gnihi/thundercloud/img/IMG_20180104_174955.jpg

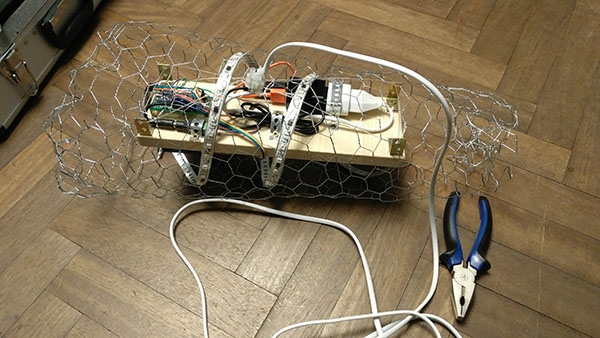
img/IMG_20180104_174955.jpg
