gnihi/thundercloud/(commit log)

2018-01-07 Refactor current state
2018-01-09 Fix bug - max average has to be a double
    [thundercloud.ino]
2018-01-09 Tweak color modes, setup a led intensity and reorder code
2018-01-12 Fix normalize function call and add average calculation afterwards
    [thundercloud.ino]
